umkoop27/Remote-Environment-Automation-Framework/README.md

Remote-Environment-Automation-Framework
=======================================

### Instructions
Full details on Software (and Hardware) for creating your own Remote-Environment-Automation-Framework is located in G07_Final_Report2014.pdf
