umkoop27/Remote-Environment-Automation-Framework/Base Station Transceiver v2/README.txt

This folder contains all of the code the base station transceiver ArduIMU v4 is programmed with.
To open the code in Arduino open file "baseStationTransceiver.ino".
