umkoop27/Remote-Environment-Automation-Framework/Hardware/Custom Component Libraries/Links to Additional Libraries.txt

Additonal Libraries placed in: C:\Users\Public\Documents\Altium\AD13\Library

RRutledge Libraries
http://code.google.com/p/altium-designer-addons/wiki/Libs_RRutledge
