umkoop27/Remote-Environment-Automation-Framework/Hardware/MotorShield/MotorShield.PDF

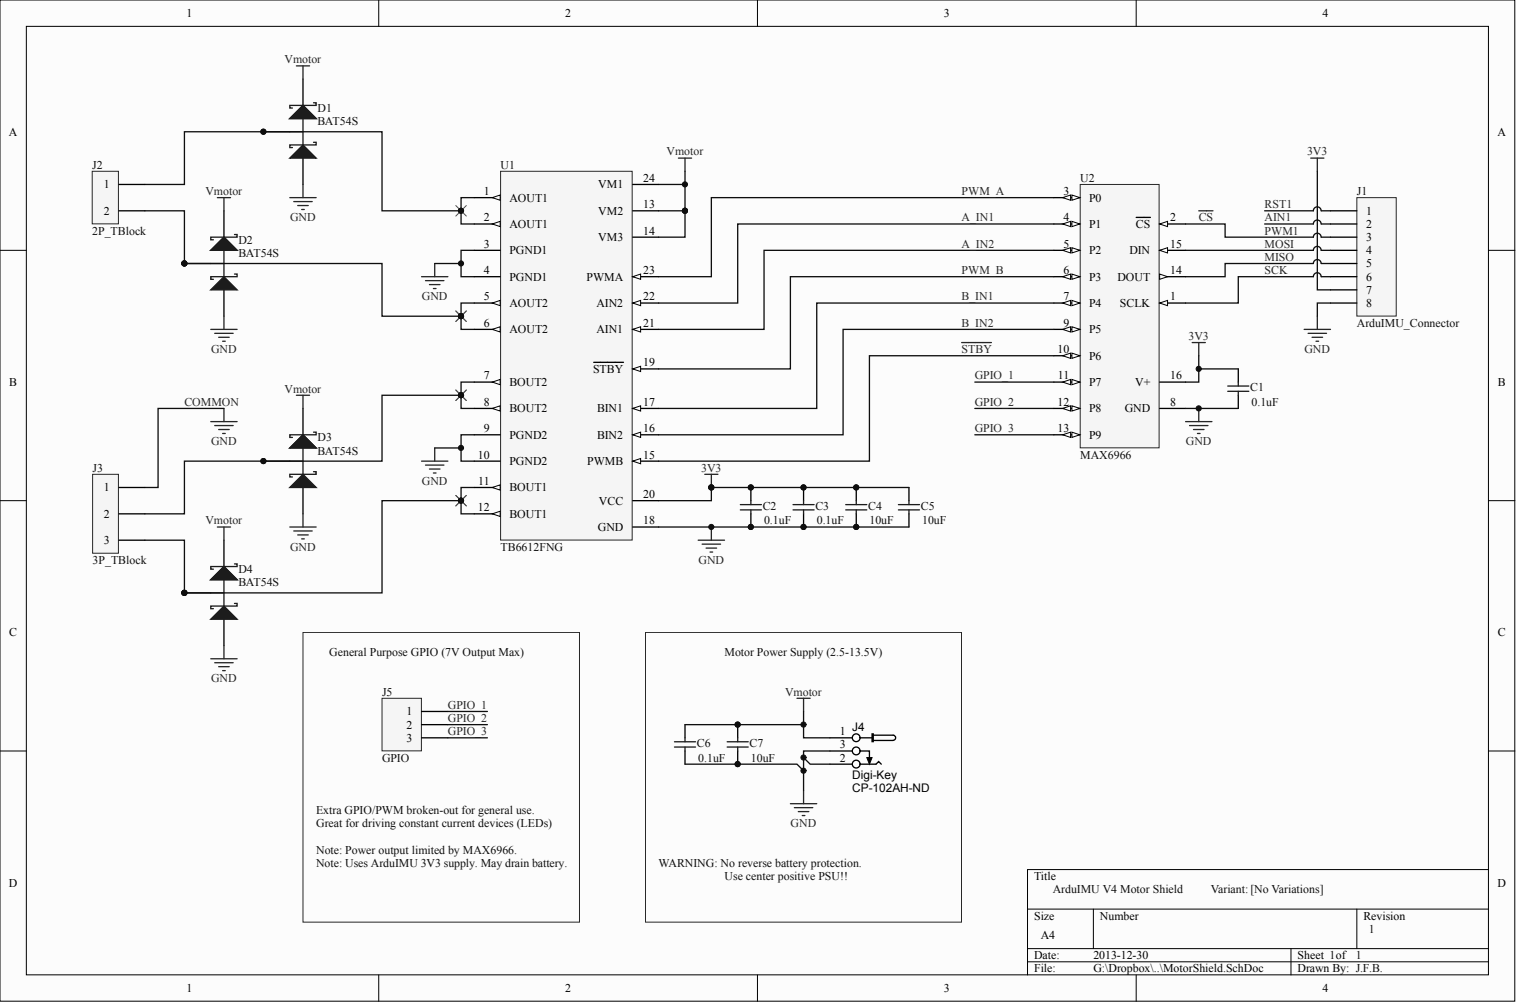
[picture p101: page 1]

STBY | | P6 10

GPIO_1 GPIO_2

General Purpose GPIO (7V Output Max

Extra GPIO/PWM broken-out for general use.
Great for driving constant current devices (LEDs)

Note: Power output limited by MAX6966.
Note: Uses ArduIMU 3V3 supply. May drain battery

WARNING: No reverse battery protection.

Use center positive PSU!!
