umkoop27/Remote-Environment-Automation-Framework/Hardware/SignalConditioningShield/SignalConditioningShield.PDF

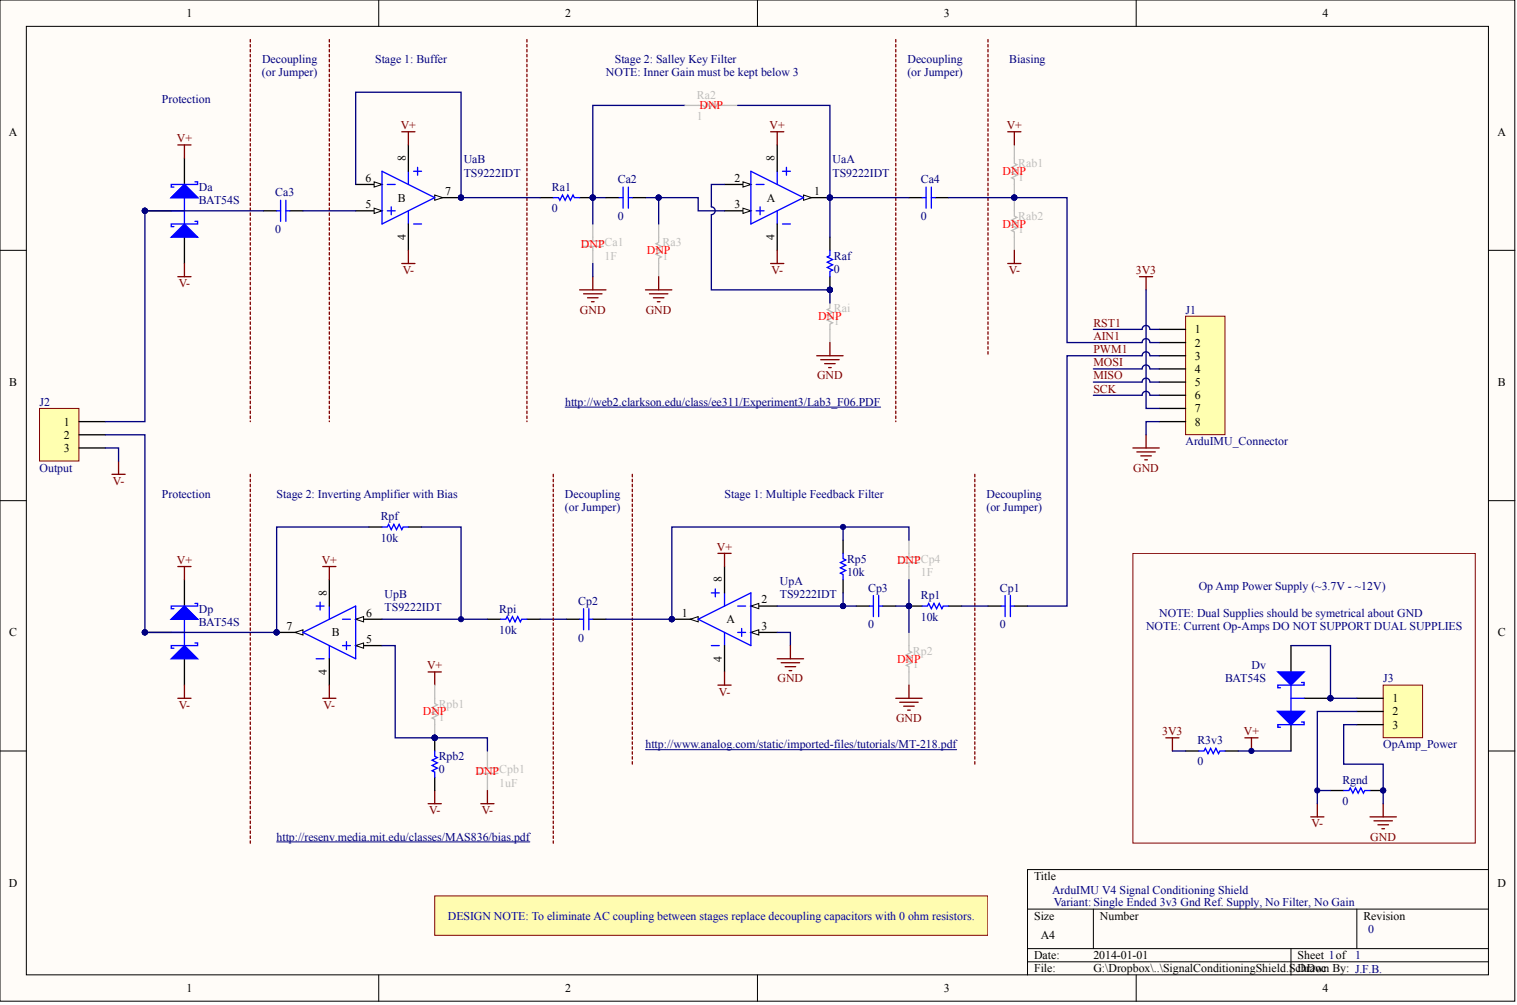
[picture p102: page 1]

Stage 2: Salley Key Filter

Variant: Single Ended 3v3 Gnd Ref. Supply, No Filter, No Gain 12345678

http://web2.clarkson.edu/class/ee311/Experiment3/Lab3_F06.PDF

Op Amp Power Supply (~3.7V - ~12V)

NOTE: Dual Supplies should be sy
NOTE: Current Op-Amps DO NOT SUPPOR

ww.analog.com/static/imported-

http://resenv.media.mit.edu/classes/MAS836/bias.pdf

Title
ArduIMU V4 Signal Conditioning Shield

To eliminate AC coupling between stages replace decoupling capacitors with 0 ohm resistors.
