umkoop27/Remote-Environment-Automation-Framework/Hardware/CompoundPeripheral/Project Outputs for CompoundPeripheral/CompoundPeripheral.PDF

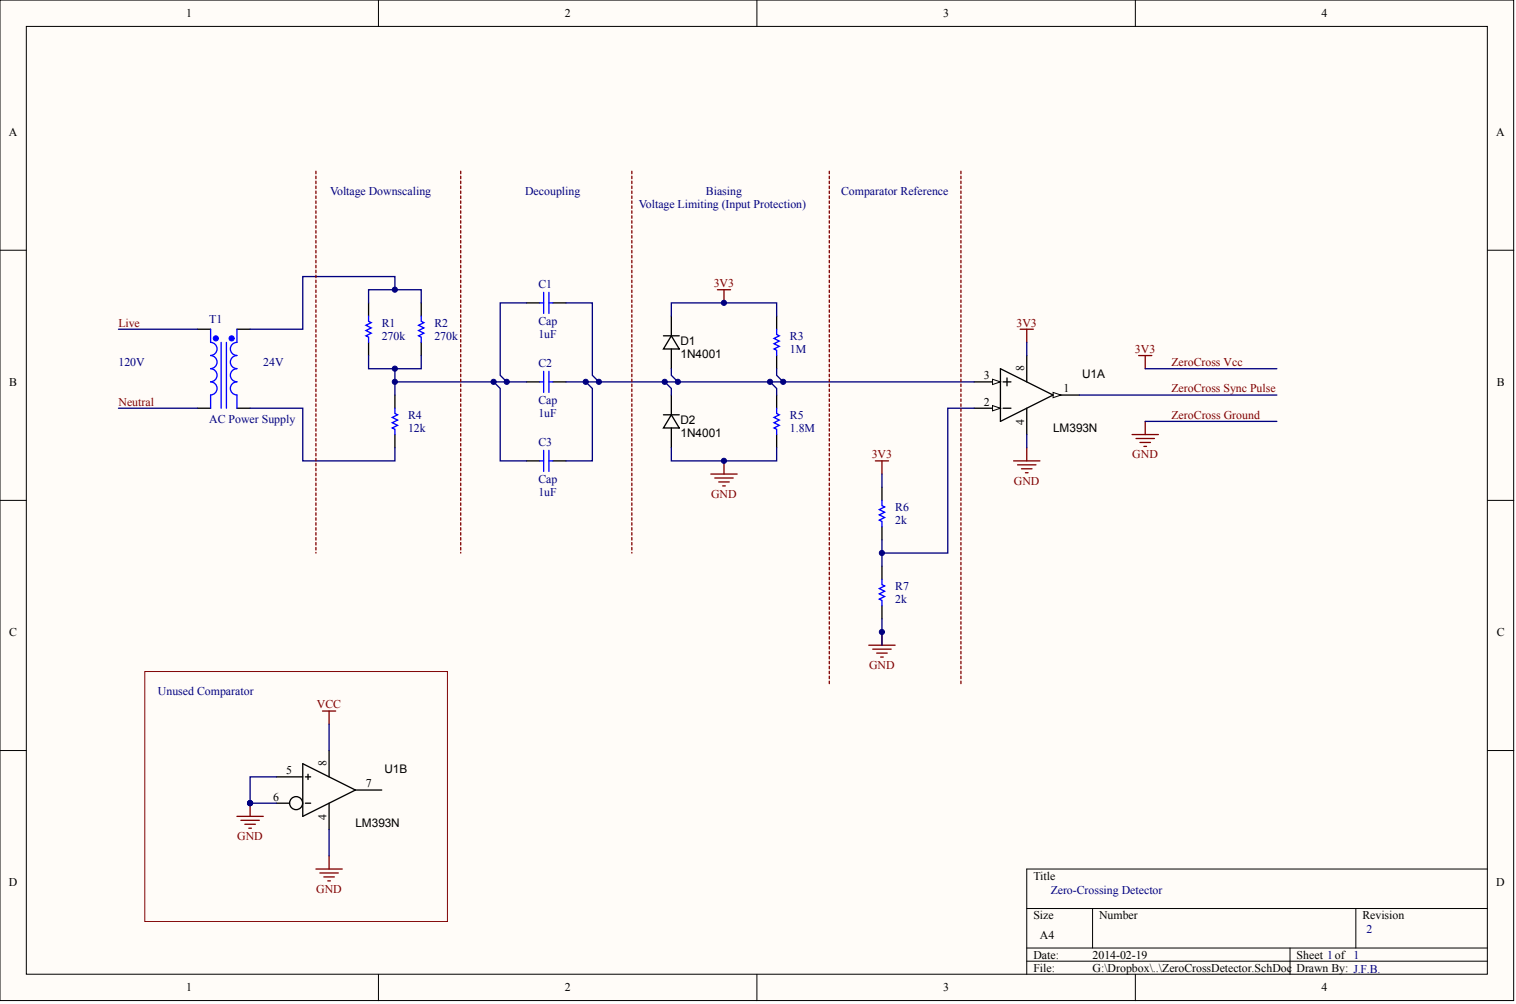
[picture p103: page 1]

Voltage Limiting (Input Protection)

ZeroCross Sync Pulse ZeroCross Vcc ZeroCross Ground
