umkoop27/Remote-Environment-Automation-Framework/Hardware/CompoundPeripheral/Project Outputs for CompoundPeripheral/Job1.PDF

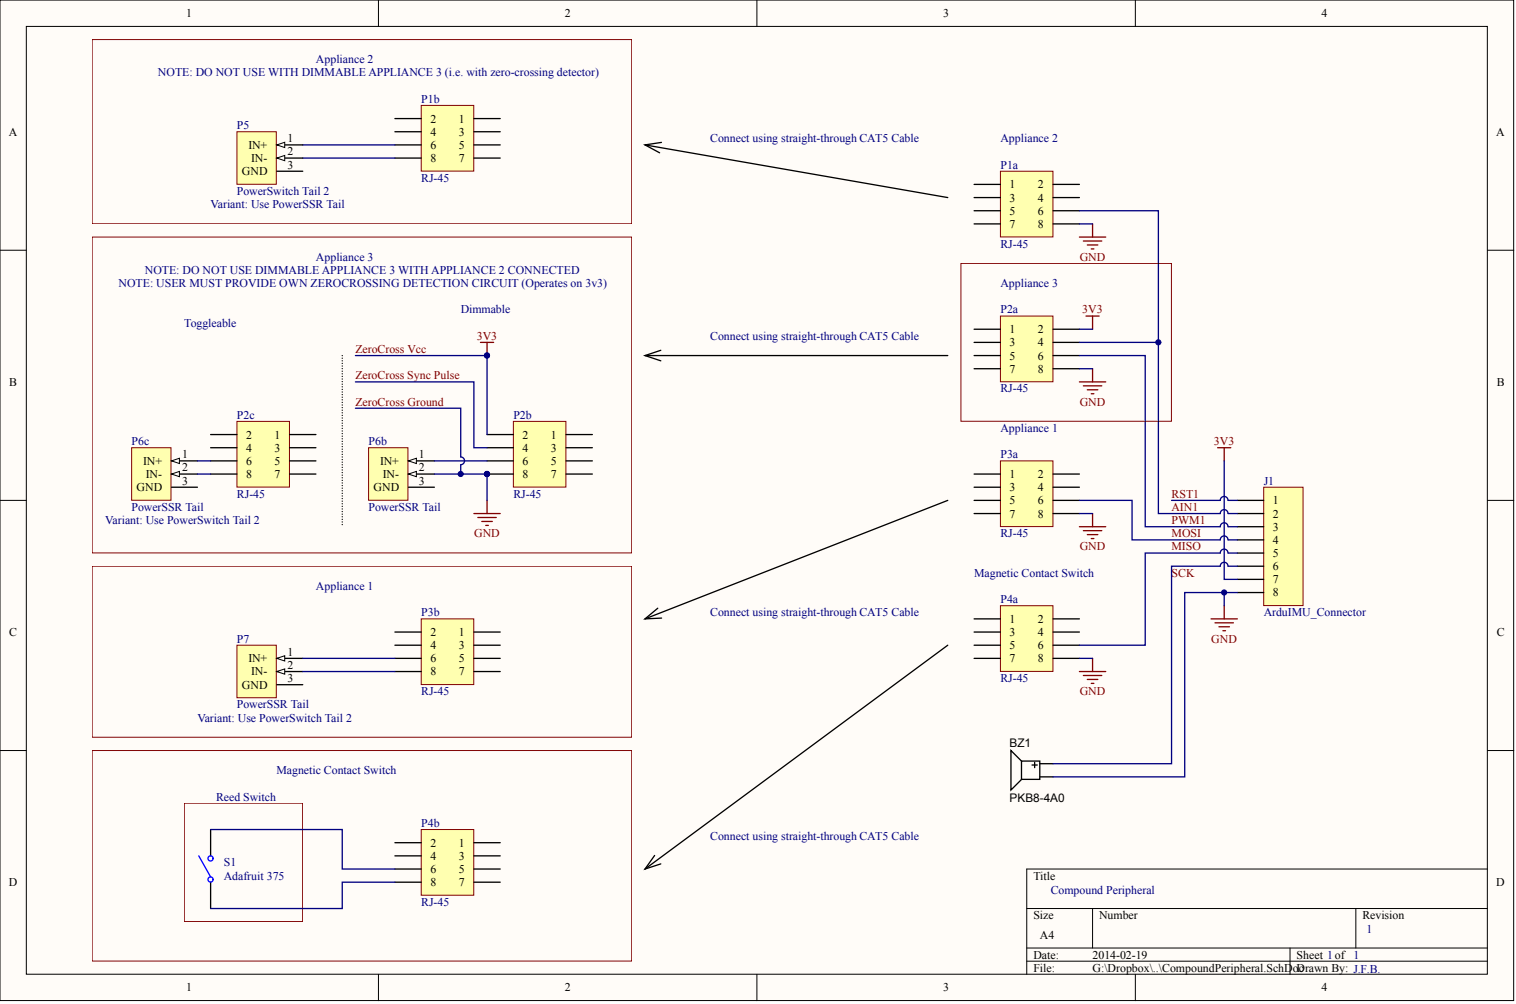
[picture p104: page 1]

NOTE: DO NOT USE WITH DIMMABLE APPL

IANCE 3 (i.e. with zero-crossing detector)

Connect using straight-through CAT5 Cable

NOTE: DO NOT USE DIMMABLE APPL
NOTE: USER MUST PROVIDE OWN ZEROCROSSING DETECTION CIRCUI

ZeroCross Sync Pulse ZeroCross Vcc ZeroCross Ground

AIN1
PWM1
