umkoop27/Remote-Environment-Automation-Framework/Hardware/LightStrip/Project Outputs for LightStrip/Job1.PDF

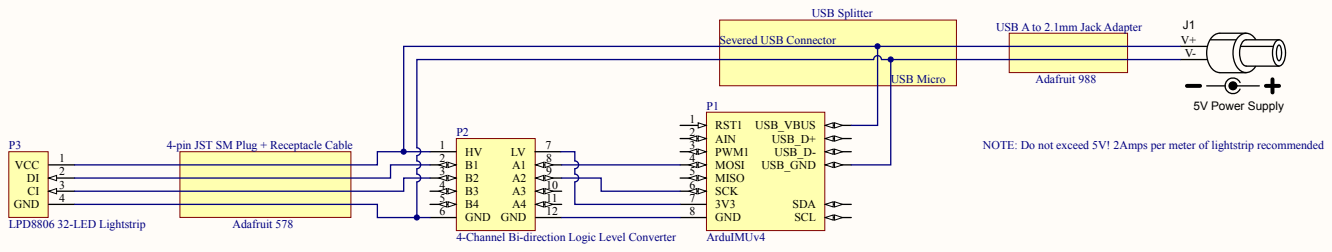
[picture p105: page 1]

4-pin JST SM Plug + Receptacle Cable

NOTE: Do not exceed 5V! 2Amps per meter of lightstrip recom

2 | 3 | | 9 5
4 | 5 | | | 1 1 | 7
