umkoop27/Remote-Environment-Automation-Framework/Hardware/IndicatorBox/IndicatorBox.PDF

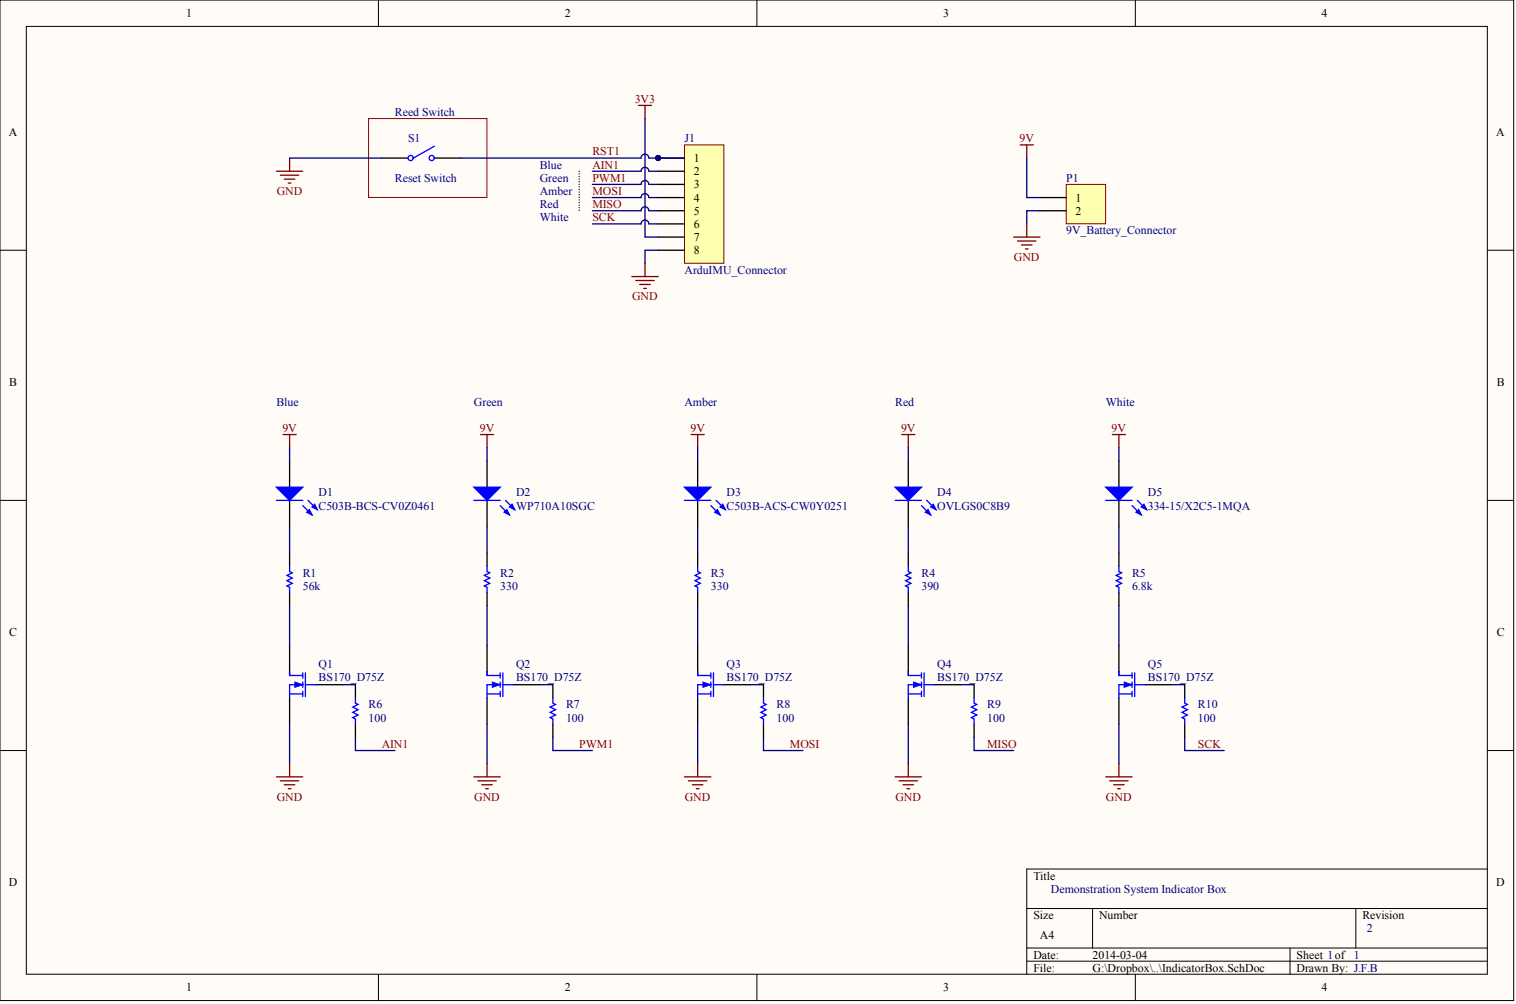
[picture p106: page 1]

Title
Demonstration System Indicator Box
