umkoop27/Remote-Environment-Automation-Framework/Hardware/ControlBox/Project Outputs for ControlBox/ControlBox.PDF

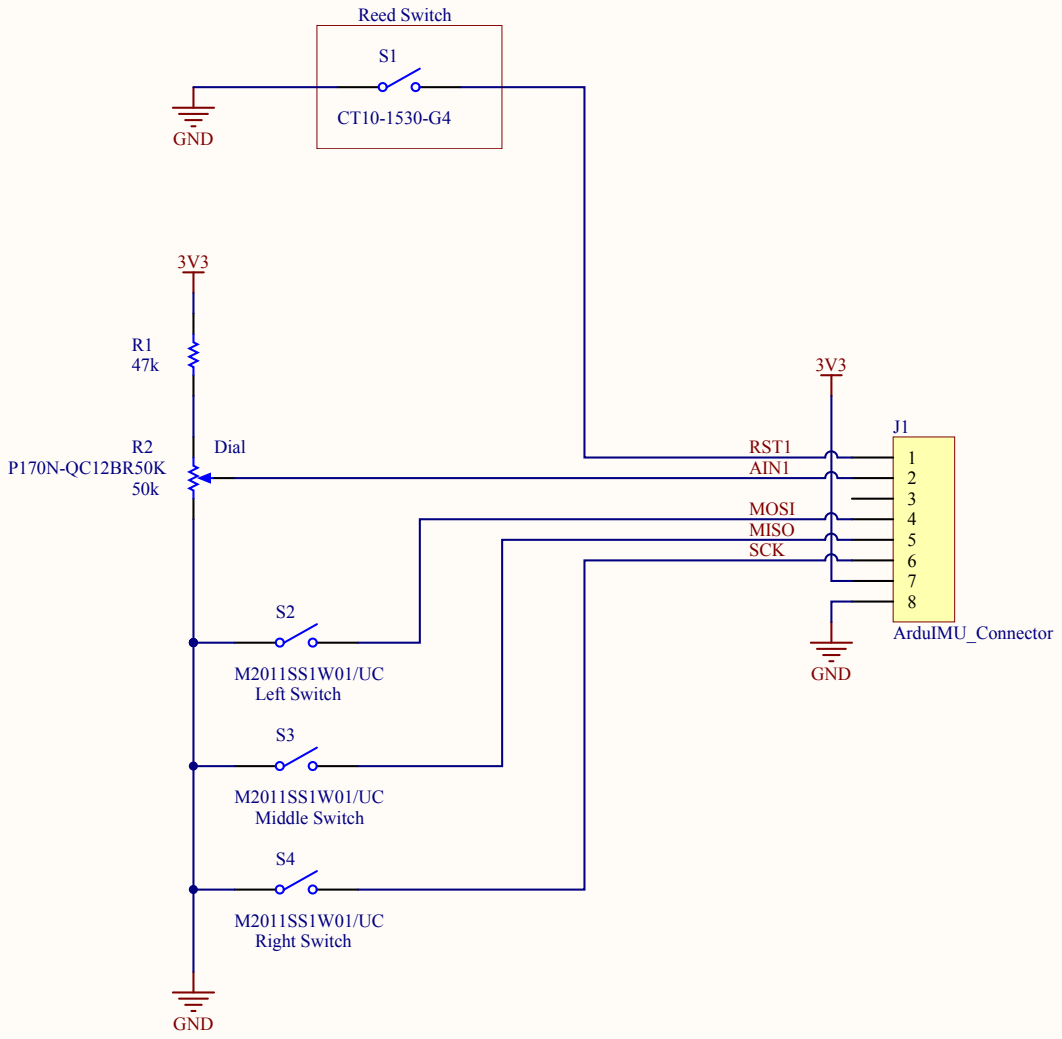
[picture p107: page 1]

Title
Demonstration System Control Box
