umkoop27/Remote-Environment-Automation-Framework/Hardware/IndicatorBox/Project Outputs for IndicatorBox/IndicatorBox.PDF

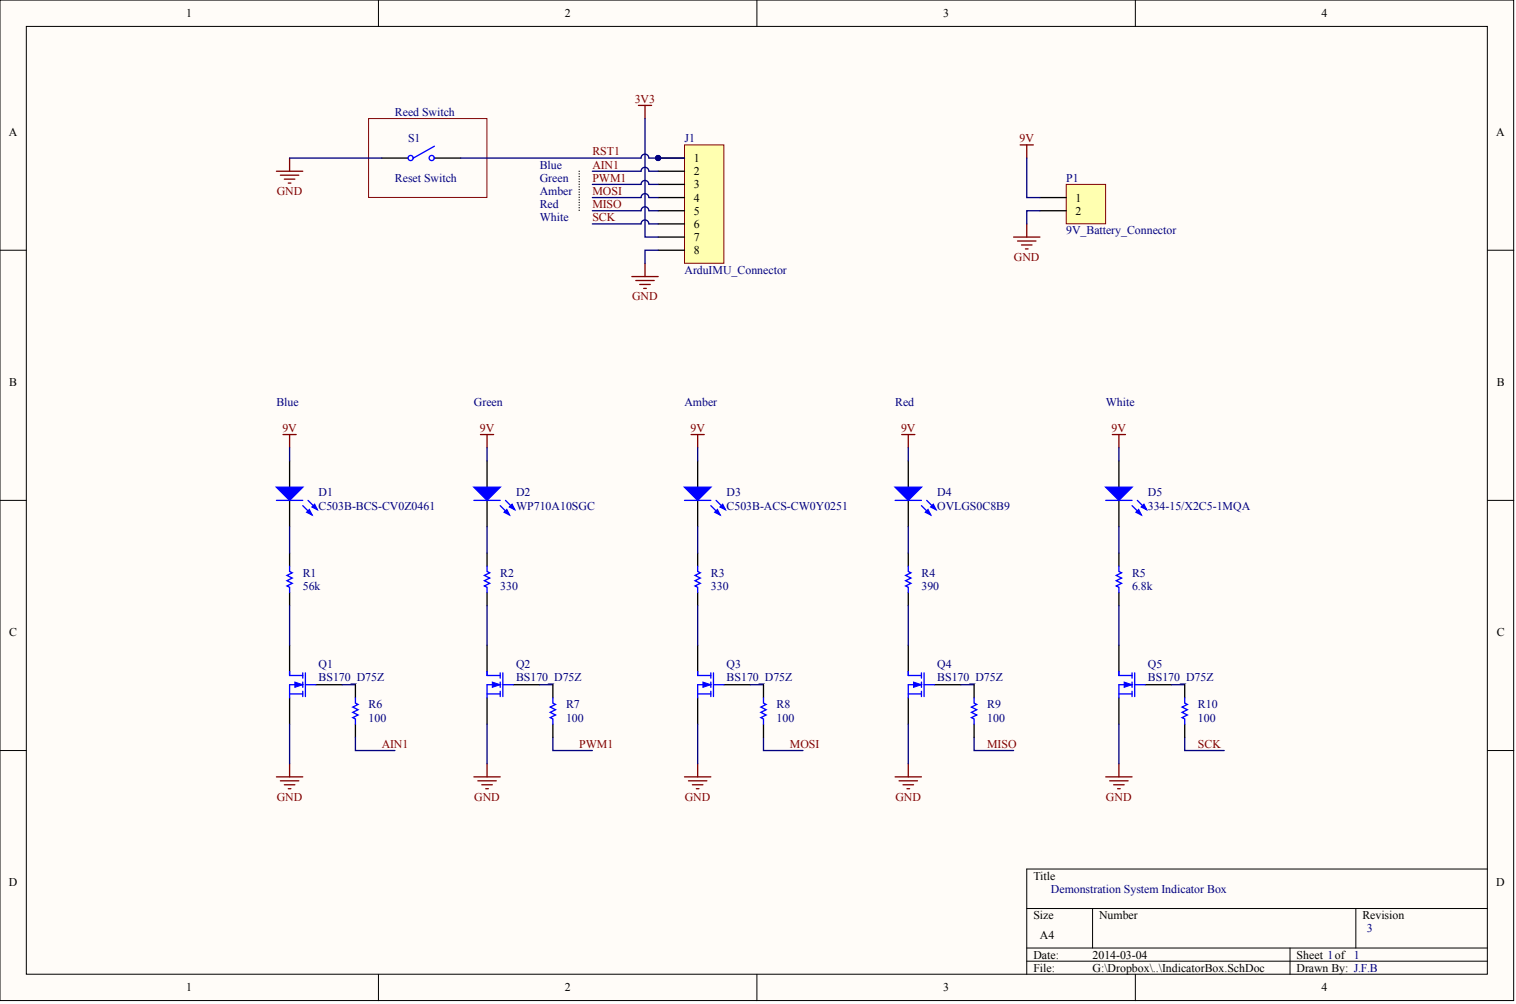
[picture p108: page 1]

Title
Demonstration System Indicator Box
