umkoop27/Remote-Environment-Automation-Framework/Hardware/MotorShield/Project Outputs for MotorShield/MotorShield.PDF

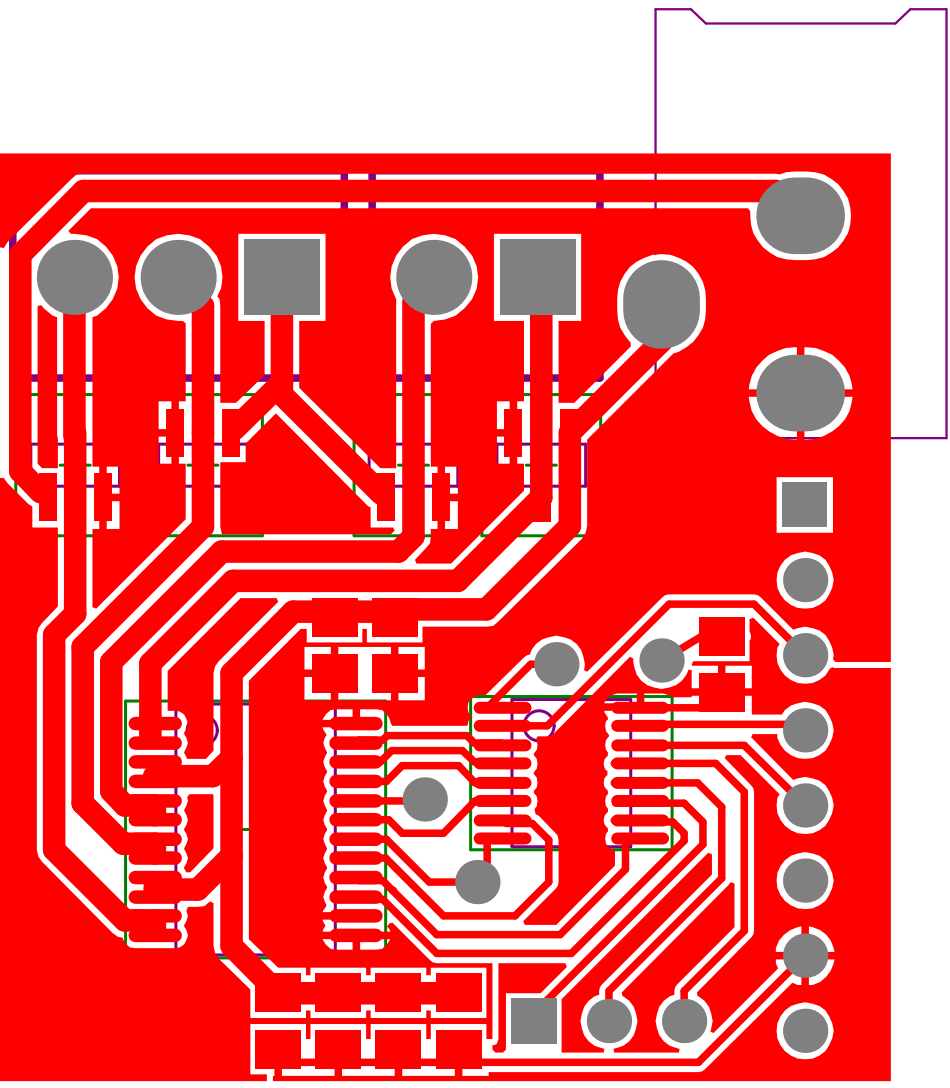
[picture p109: page 1]

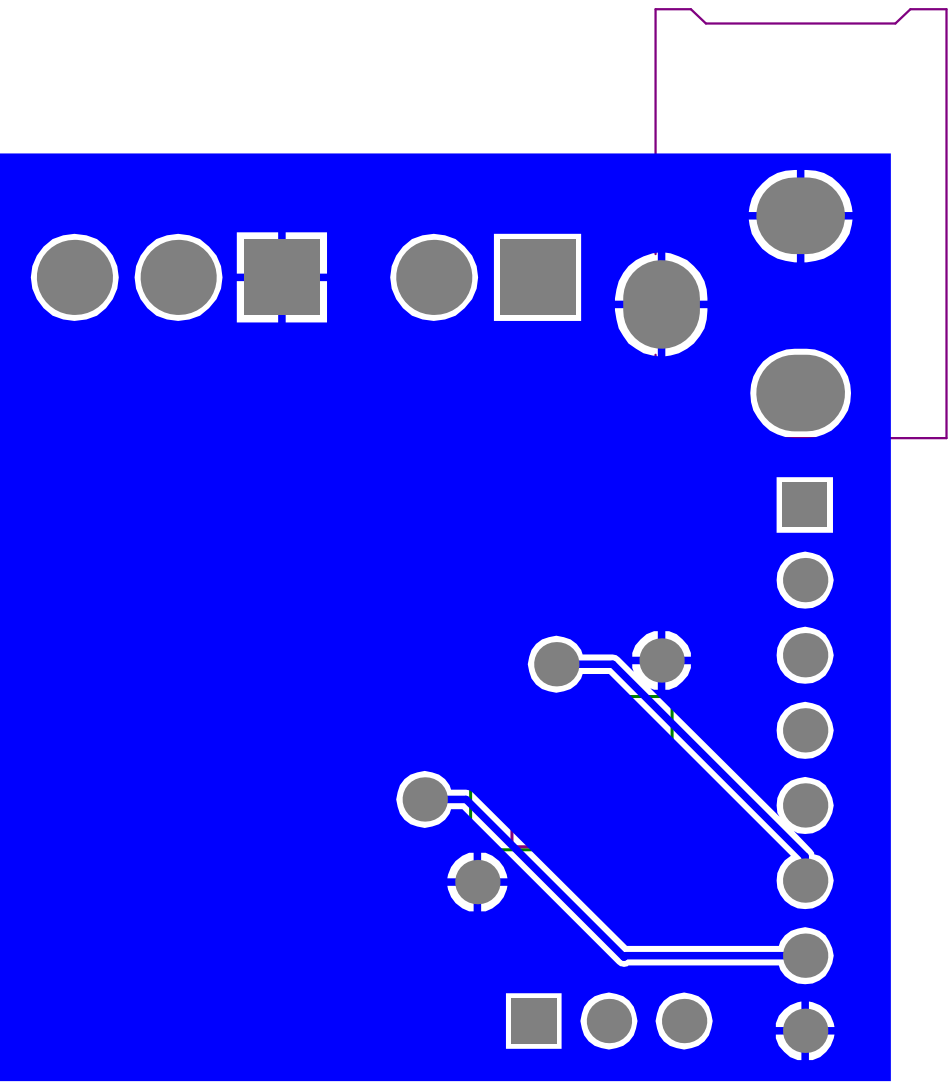
[picture p110: page 2]

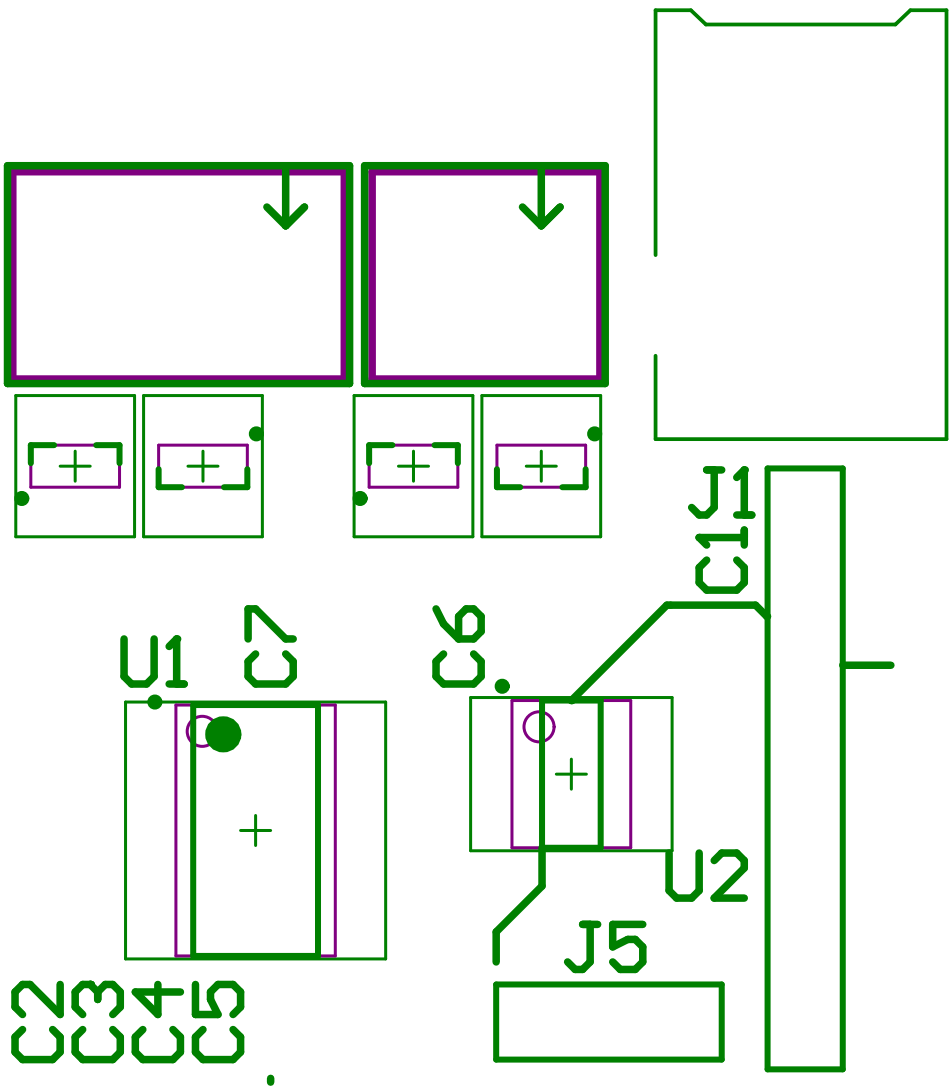
[picture p111: page 3]

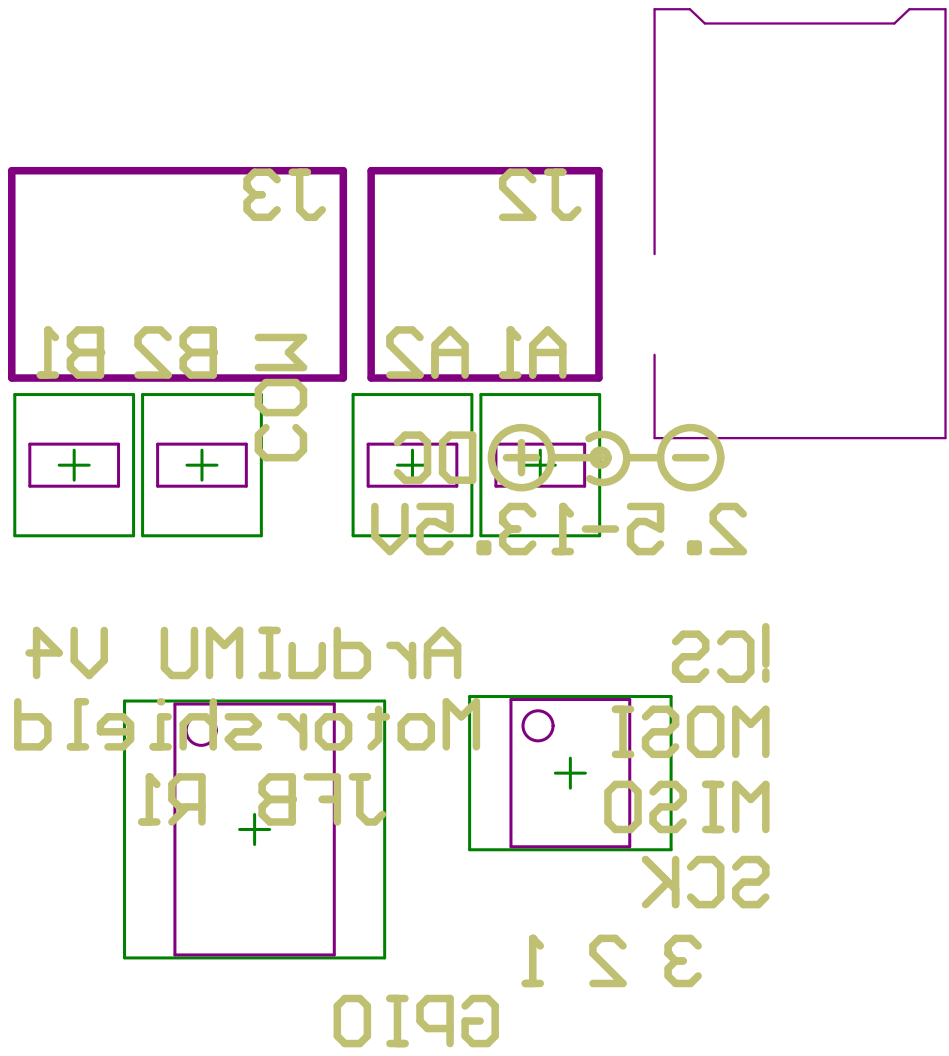
[picture p112: page 4]

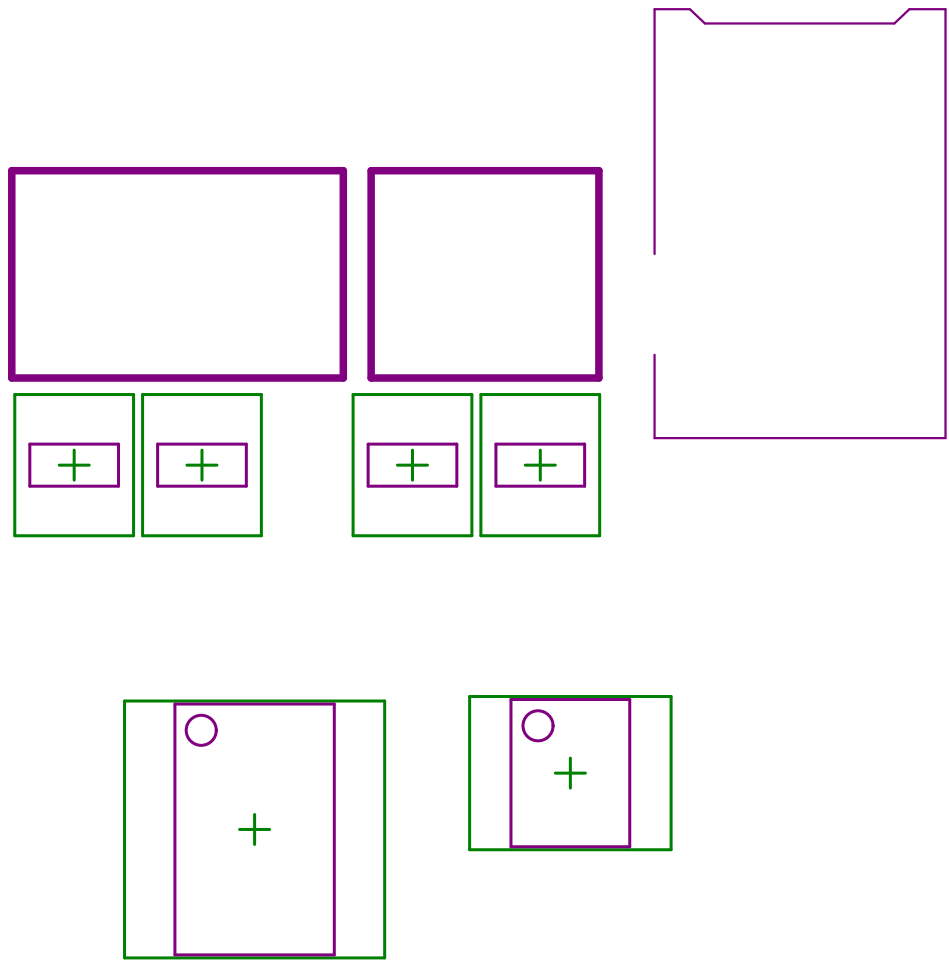
[picture p113: page 5]

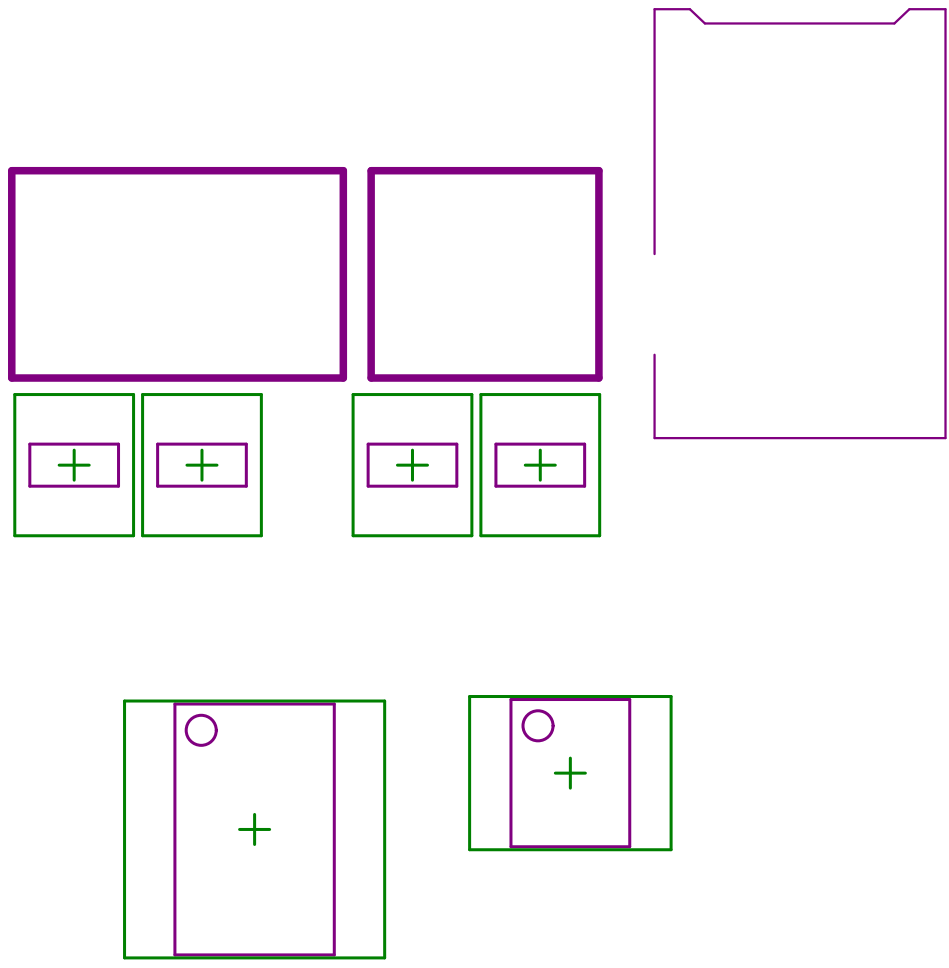
[picture p114: page 7]

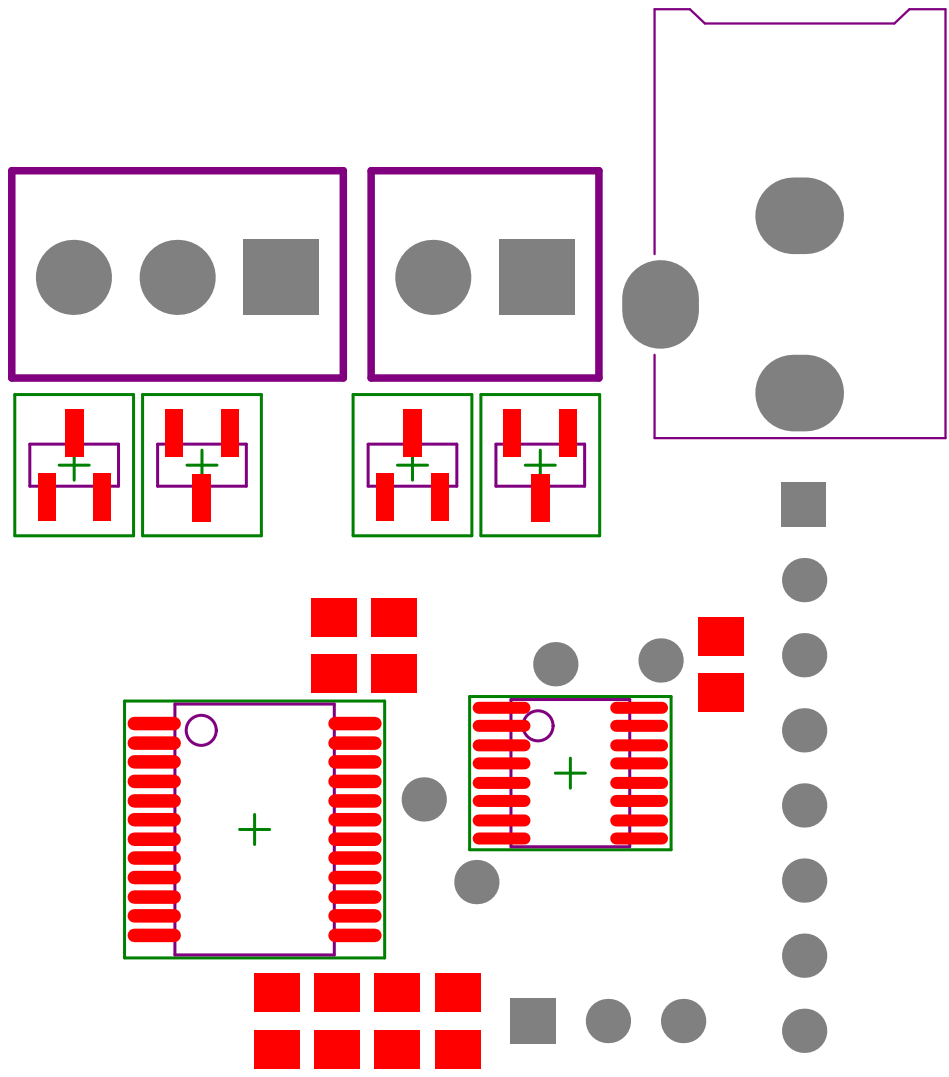
[picture p115: page 8]

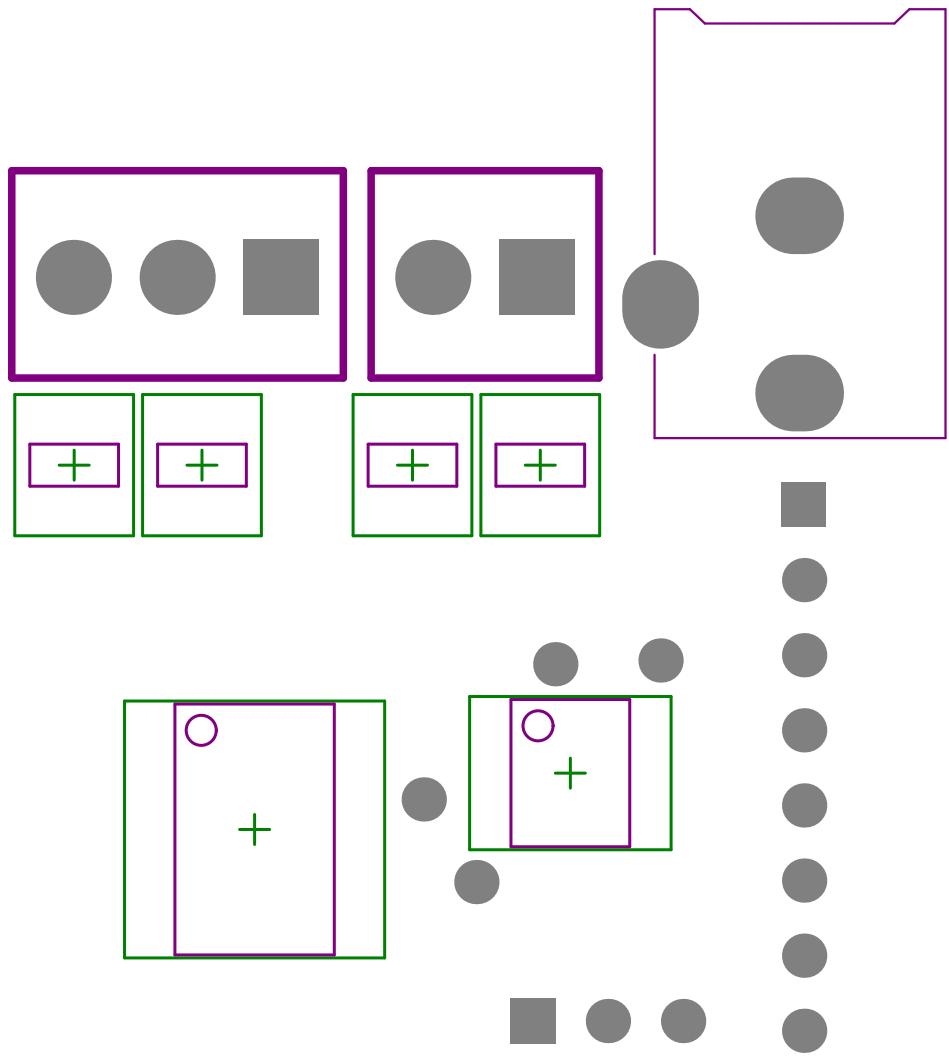
[picture p116: page 9]

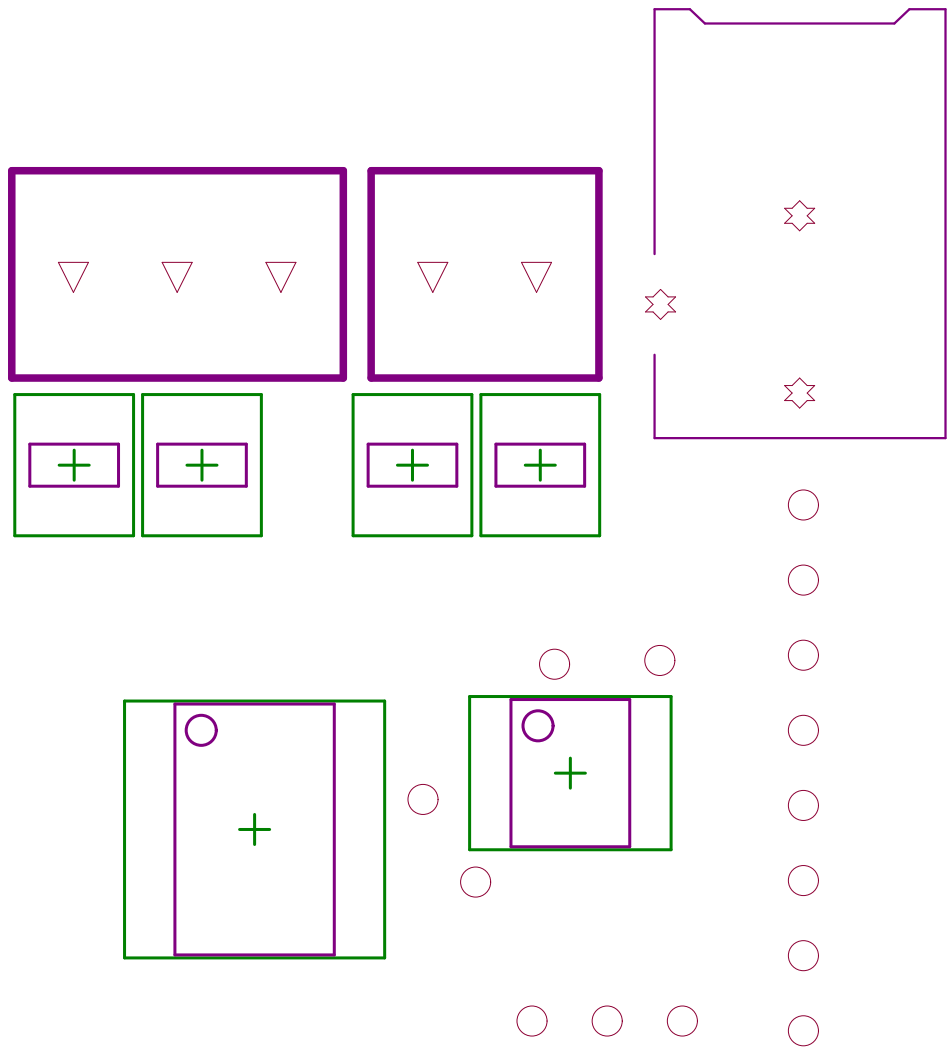
[picture p117: page 10]

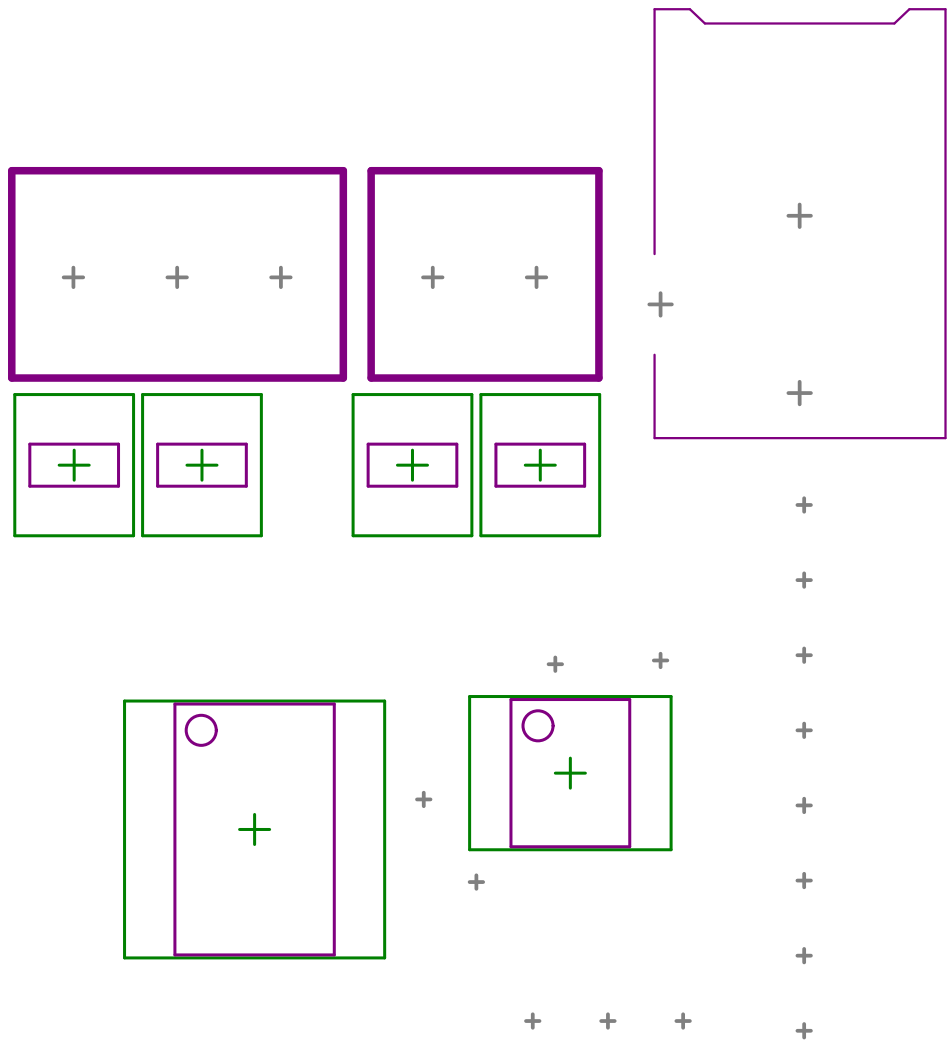
[picture p118: page 11]
