umkoop27/Remote-Environment-Automation-Framework/(list of files, drawings)

Other design files:
Hardware/CompoundPeripheral/CompoundPeripheral.PrjPCB
Hardware/CompoundPeripheral/CompoundPeripheral.SchDoc
Hardware/CompoundPeripheral/ZeroCrossDetector.SchDoc
Hardware/ControlBox/ControlBox.PrjPCB
Hardware/ControlBox/ControlBox.SchDoc
Hardware/Custom Component Libraries/3.5mmJack.PcbLib
Hardware/Custom Component Libraries/CustomPeripherals.SchLib
Hardware/Custom Component Libraries/Microchip Interface/Microchip Interface.PcbLib
Hardware/Custom Component Libraries/Microchip Interface/Microchip Interface.SchLib
Hardware/Custom Component Libraries/Microchip Linear Devices/Microchip Linear Devices.PcbLib
Hardware/Custom Component Libraries/Motorshield.PcbLib
Hardware/Custom Component Libraries/Motorshield.SchLib
Hardware/GPIOExpander/GPIOExpander.PcbDoc
Hardware/GPIOExpander/GPIOExpander.PrjPCB
Hardware/GPIOExpander/GPIOExpander.SchDoc
Hardware/IndicatorBox/IndicatorBox.PrjPCB
Hardware/IndicatorBox/IndicatorBox.SchDoc
Hardware/LightStrip/LightStrip.PrjPCB
Hardware/LightStrip/LightStrip.SchDoc
Hardware/MotorShield/MotorShield.PcbDoc
Hardware/MotorShield/MotorShield.PrjPCB
Hardware/MotorShield/MotorShield.SchDoc
Hardware/SignalConditioningShield/SignalConditioningShield.PcbDoc
Hardware/SignalConditioningShield/SignalConditioningShield.PcbLib
Hardware/SignalConditioningShield/SignalConditioningShield.PrjPCB
Hardware/SignalConditioningShield/SignalConditioningShield.SchDoc
Hardware/SignalConditioningShield/SignalConditioningShield.SchLib
Hardware/SignalConditioningShield/SignalConditioningShieldBackup.PcbDoc
