umkoop27/Remote-Environment-Automation-Framework/(commit log)

2014-03-06 Add Hardware folder
    [3.5mmJack.PcbLib, CompoundPeripheral.PrjPCB, CompoundPeripheral.SchDoc, ControlBox.PrjPCB, ControlBox.SchDoc, CustomPeripherals.SchLib, GPIOExpander.PcbDoc, GPIOExpander.PrjPCB]
2014-03-10 Add Peripheral Framework folder
